mateustoin/Sistema-de-Deteccao-e-Analise-de-Agua/img/circuito-geral.png

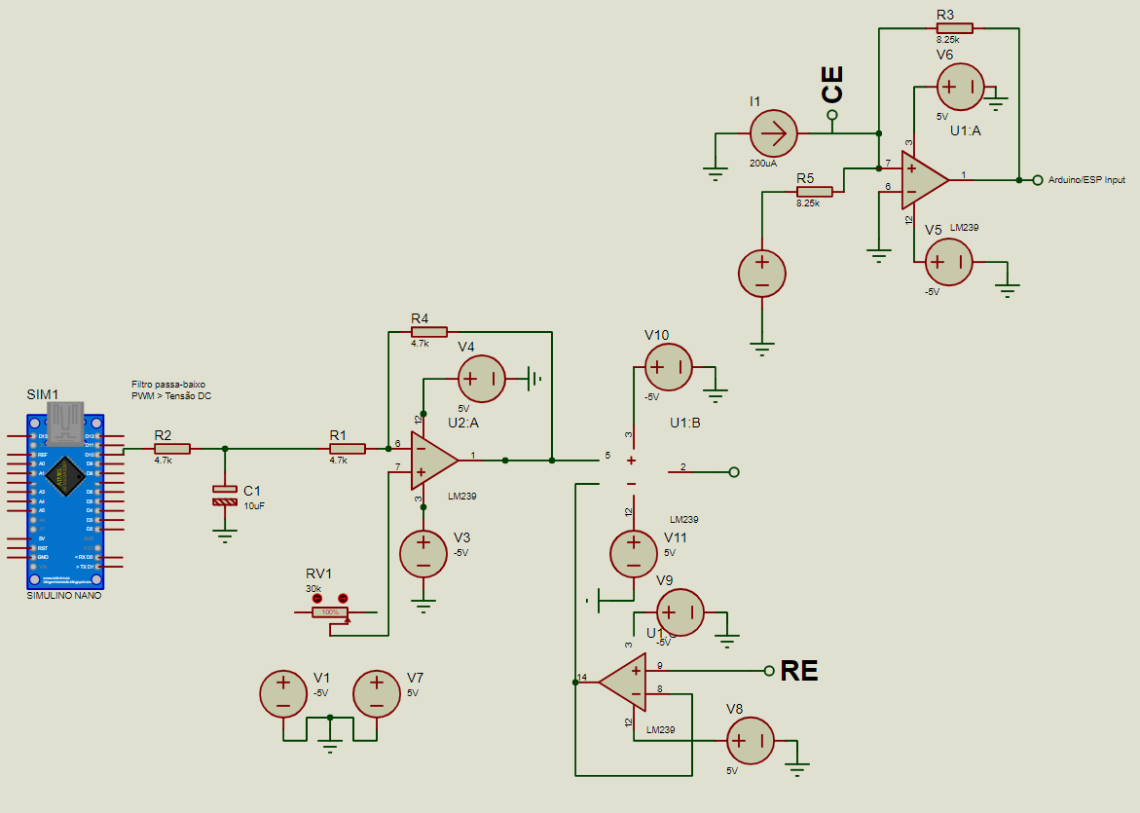
img/circuito-geral.png
