mateustoin/Sistema-de-Deteccao-e-Analise-de-Agua/img/pcb.png

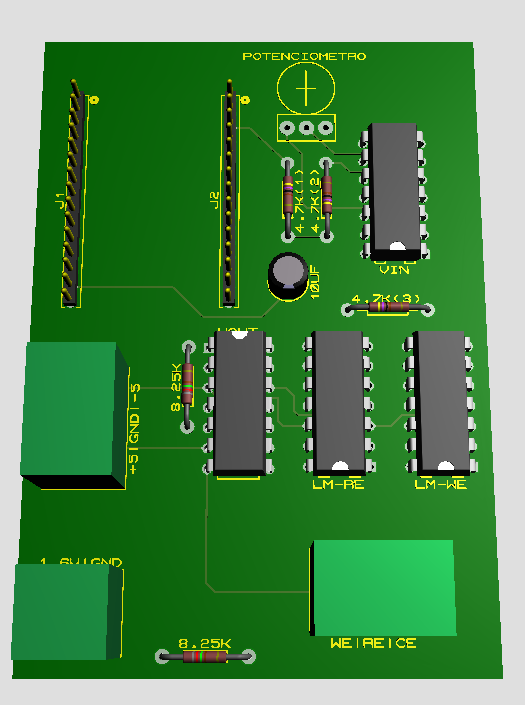
img/pcb.png
