mateustoin/Sistema-de-Deteccao-e-Analise-de-Agua/img/pcb/final-pcb-nodemcu-back.png

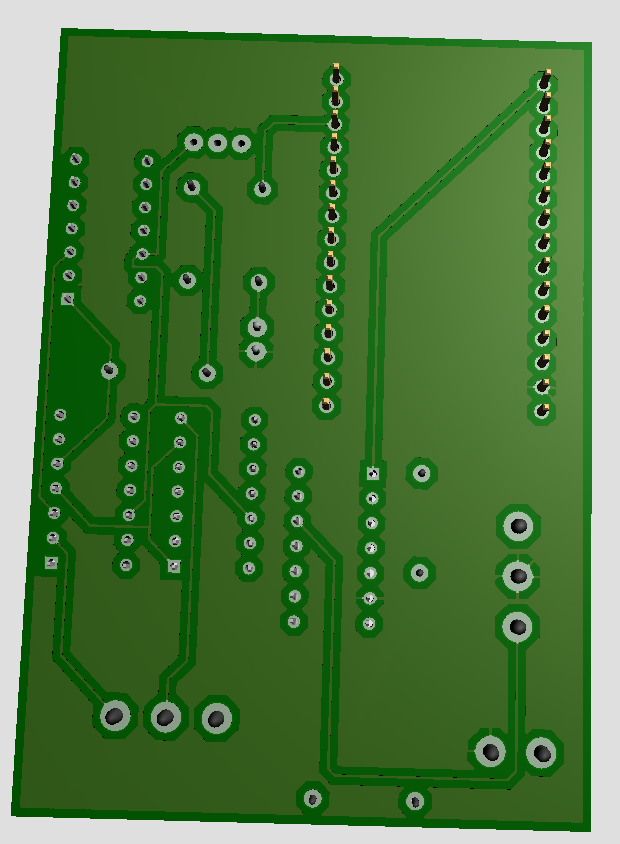
img/pcb/final-pcb-nodemcu-back.png
