mateustoin/Sistema-de-Deteccao-e-Analise-de-Agua/img/pcb_fundo.png

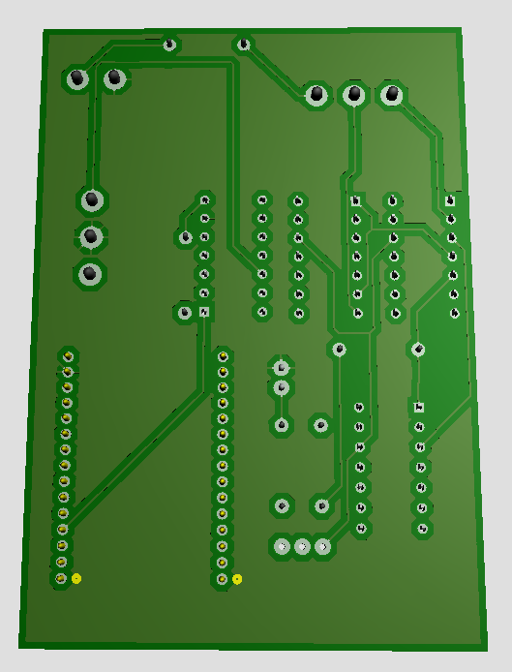
img/pcb_fundo.png
