mateustoin/Sistema-de-Deteccao-e-Analise-de-Agua/img/pt1-simul/circuito-arduino-nano-passa-baixo.png

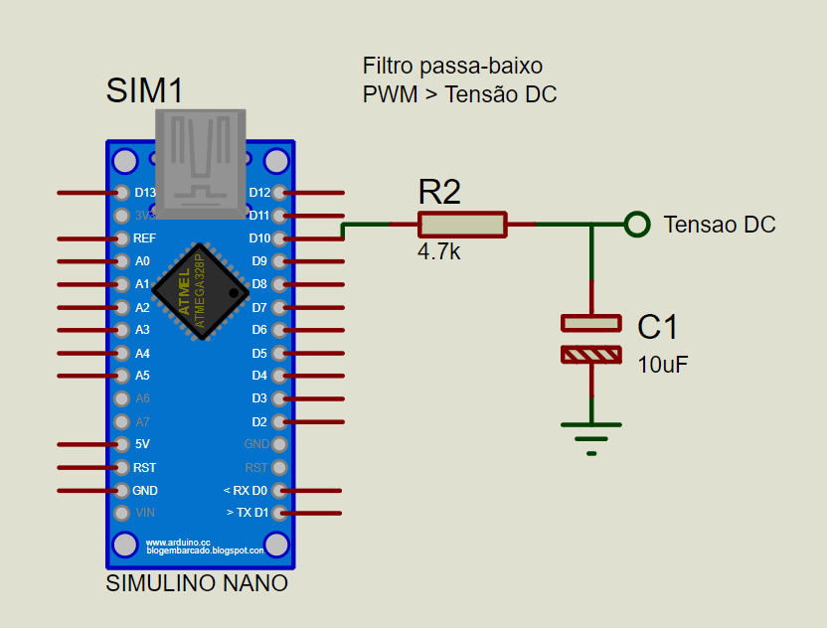
img/pt1-simul/circuito-arduino-nano-passa-baixo.png
