mateustoin/Sistema-de-Deteccao-e-Analise-de-Agua/img/pt2-simul/circuito2.png

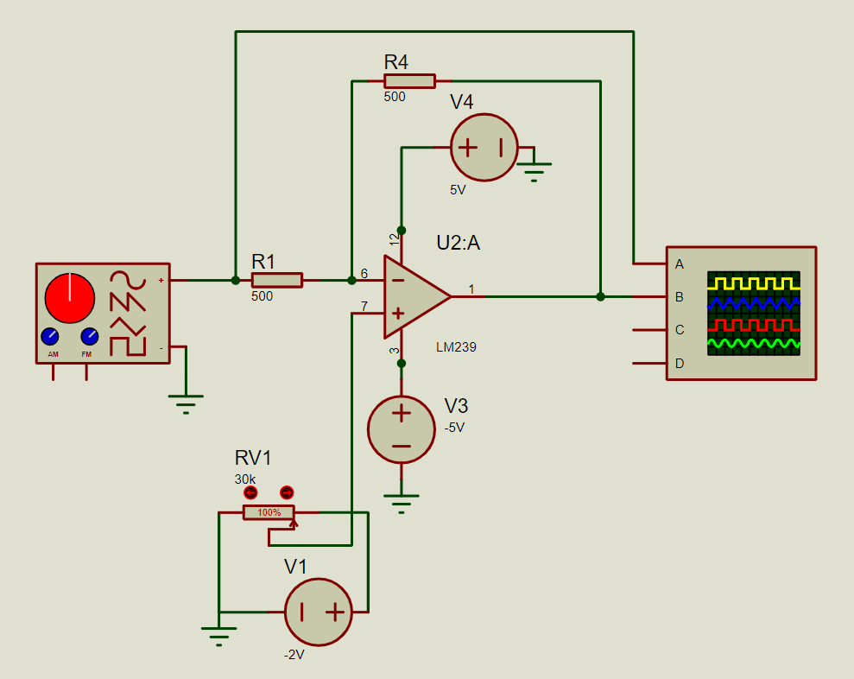
img/pt2-simul/circuito2.png
