mateustoin/Sistema-de-Deteccao-e-Analise-de-Agua/(list of files, drawings)

Other design files:
circuitos/circuito-final-pcb/circuito-pcb.pdsprj
circuitos/circuito-final.pdsprj
circuitos/lais-circuit.pdsprj
