mateustoin/Sistema-de-Deteccao-e-Analise-de-Agua/codes/deteccao_analise/include/FileIO.h

#ifndef fileio_h
#define fileio_h

#include "FS.h"
#include "SPIFFS.h"

/* You only need to format SPIFFS the first time you run a
   test or else use the SPIFFS plugin to create a partition
   https://github.com/me-no-dev/arduino-esp32fs-plugin */
#define FORMAT_SPIFFS_IF_FAILED true

void listDir(fs::FS &fs, const char * dirname, uint8_t levels);
void readFile(fs::FS &fs, const char * path);
void writeFile(fs::FS &fs, const char * path, const char * message);
void appendFile(fs::FS &fs, const char * path, const char * message);
void renameFile(fs::FS &fs, const char * path1, const char * path2);
void deleteFile(fs::FS &fs, const char * path);
void testFileIO(fs::FS &fs, const char * path);

// Modificações para o projeto de análise Cíclica de Voltametria
void appendFileVoltammetry(fs::FS &fs, const char * path, const char * voltage, const char * current);
// Verifica se arquivo já existe. Retorna true se já existe.
bool verifyFile(fs::FS &fs, const char * path);

#endif
