mateustoin/Sistema-de-Deteccao-e-Analise-de-Agua/(commit log)

2020-12-21 docs: Imagens finais de circuito
2020-12-21 docs: Imagens e Documentação Obrigatória
    Imagens adicionadas para a documentação que agora está com a parte
    obrigatória pronta.
2020-12-21 feat: Código para teste de PWM to DC Voltage.
    Código para testar a saída PWM do Arduino com o circuito de Filtro
    passa-baixo.
2020-12-21 docs: Código para plottar e testar PWM to DC
2020-12-21 feat: Web page para visualização de gráficos
2020-12-21 docs: Correção na tabela de materiais
2020-12-21 feat: Versão inicial da voltametria
2020-12-21 feat: Rotina de Voltametria ciclica básica concluída
2020-12-21 feat: Construção de função salvamento info na SPIFFS
2020-12-21 feat: Funções para facilitar a escrita no arquivo
    Funções para escrever dados de corrente, tensão e verificação se o
    arquivo existe adicionados.
2020-12-22 feat: Bibliotecas relacionadas ao Firebase ESP32
2020-12-22 feat: Versão para entrega da documentação
    [circuito-final.pdsprj, circuito-pcb.pdsprj, lais-circuit.pdsprj, voltametria.csv]
